Ortigaa/poti-multiplexer/parts.xlsx

Part | Number needed | Explanation | Price (st.) | Number to buy | Notes | url | Final price | Total
Relais shield | 1 | Switching between channels | 14.49 | 1 |  | https://www.conrad.de/de/p/joy-it-kompatibles-board-arduino-mega-2560r3-1409778.html | 7.49
Control for relais | 1 | Arduino or similar for switching control | 13.79 | 1 |  | https://www.conrad.de/de/p/joy-it-kompatibles-board-arduino-mega-2560r3 (https://mail.uni-freiburg.de/SRedirect/F362A017/www.conrad.de/de/p/joy-it-kompatibles-board-arduino-mega-2560r3) | 13.79
Bus cable | 2x10 channels | Connection between relay shield and arduino | 5.99 | 1 |  | https://www.conrad.de/de/p/renkforce-jkmf406-jumper-kabel-arduino-banana-pi-raspberry-pi-40x-drahtbruecken-stecker-40x-drahtbruecken-buchse-60-2299841.html | 5.99
DB9 connector | 8 | Connection to potentiostat trigger signal | 4.58 | 8 |  | https://www.conrad.de/de/p/mh-connectors-mhdm9-db9p-k-d-sub-stiftleisten-set-180-polzahl-9-loetkelch-1-st-1210645.html | 36.64
Multi-channel cable (3>= channels <= 9) | at least 10m | Connection to potentiostat control: from DB9 to Arduino (price per m, 15m) | 1.33 | 15 |  | https://www.conrad.de/de/p/lapp-1026709-1-schleppkettenleitung-oelflex-chain-809-3-g-0-75-mm-grau-meterware-608779.html | 19.95
Mini bannana (2mm) male welded, red | 8 | extend poti electrodes (10/pk) | 0.906 | 1 |  | https://www.mouser.de/ProductDetail/Pomona-Electronics/5936-2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 | 0.906
Mini bannana (2mm) male welded, black | 8 | extend poti electrodes (10/pk) | 0.906 | 1 |  | https://www.mouser.de/ProductDetail/Pomona-Electronics/5936-0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 | 0.906
Mini bannana (2mm) female (socket) welded | 8 | extend poti electrodes (5/pk) | 2.62 | 2 |  | https://www.mouser.de/ProductDetail/Pomona-Electronics/72922-2?qs=2nDnb8a6ouMdaUK3ctZP6A%3D%3D | 5.24
1.5mm cable (red) | 5m | extend poti electrodes (price per m, 5m) | 0.6 | 5 |  | https://www.conrad.de/de/p/lapp-4520041-1-litze-h07v-k-1-x-1-50-mm-rot-meterware-607662.html | 3
1.5mm cable (black) | 5m | extend poti electrodes (price per m, 5m) | 0.6 | 5 |  | https://www.conrad.de/de/p/lapp-4520011-1-litze-h07v-k-1-x-1-50-mm-schwarz-meterware-607619.html | 3
1.5mm cable (blue) | 5m | extend poti electrodes (price per m, 5m) | 0.6 | 5 |  | https://www.conrad.de/de/p/lapp-4520021-1-litze-h07v-k-1-x-1-50-mm-hellblau-meterware-607640.html | 3
PCB boards | 1 | various connections | 2.85 | 4 |  | https://www.conrad.de/de/p/rademacher-wr-typ-811-2-platine-hartpapier-l-x-b-100-mm-x-75-mm-35-m-rastermass-2-54-mm-inhalt-1-st-529580.html | 11.4
Resistors |  | various connections (always good to have) | 9.99 | 1 |  | https://www.conrad.de/de/p/tru-components-418706-kohleschicht-widerstand-sortiment-axial-bedrahtet-5-390-teile-1564789.html | 9.99
Shrinking tube |  | various connections | 8.99 | 1 |  | https://www.conrad.de/de/p/tru-components-tc-6793940-schrumpfschlauchsortiment-schwarz-schrumpfrate-3-1-100-st-1698485.html | 8.99
Header Pin connectors female |  | various connections | 0.966 | 5 |  | https://www.mouser.de/ProductDetail/Samtec/SSW-110-01-T-S?qs=mo%2F4pi%252B%2FVOuo0hu9zJBzaA%3D%3D | 4.83
Computer Fan (120mm) | 2 | Cooling of cells during measurement | 25.3 | 2 | Maybe cheaper in omega | https://www.mouser.de/ProductDetail/Orion-Fans/OD1225-12HBIP69K?qs=zW32dvEIR3vqWiZqa0kqcw%3D%3D | 50.6
cable with inline switch | 2 | Cooling of cells during measurement |  | 2 | Turn on/off fans, but we could just unplug them | Probably in omega | 0
Current adaptor for Fans (if needed) | 2 | Cooling of cells during measurement |  | 2 | Fans likely to work at 5 or 12V, so we need a regulator | Probably in omega | 0
2 channel connectors (female) | 8 | Connect signal cables from poti to duty box | 0.558 | 10 |  | https://www.mouser.de/ProductDetail/TE-Connectivity-AMP/1-480319-9?qs=ko0lFLRalINLBF3JMpSURA%3D%3D | 5.58
2 channel connectors (male) | 8 | Connect signal cables from poti to duty box | 0.469 | 10 |  | https://www.mouser.de/ProductDetail/?qs=ko0lFLRalIM5L%2F%2FJBG4PpQ%3D%3D | 4.69
2 channel connectors pins (female) | 16 | Connect signal cables from poti to duty box | 0.215 | 20 |  | https://www.mouser.de/ProductDetail/?qs=pn%2Fzyis3XjGFb4jHYYY9Mg%3D%3D | 4.3
2 channel connectors pins (male) | 16 | Connect signal cables from poti to duty box | 0.218 | 20 |  | https://www.mouser.de/ProductDetail/?qs=pn%2Fzyis3XjF3U6DRLMBbCg%3D%3D | 4.36
Servo motor for shutter | 8 | Open and close shutter for each cell | 5.84 | 2 |  | https://www.mouser.de/ProductDetail/DFRobot/SER0047 | 11.68
 |  |  |  |  |  |  | 0
 |  |  |  |  |  |  | 0
 |  |  |  |  |  |  | 0
 |  |  |  |  |  |  | 0
 |  |  |  |  |  |  | 0
 |  |  |  |  |  |  | 0
 |  |  |  |  |  |  | 0
 |  |  |  |  |  |  | 0
 |  |  |  |  |  |  | 0
 |  |  |  |  |  |  |  | 216.332
