Ortigaa/poti-multiplexer/holding_box/assembly.FCStd

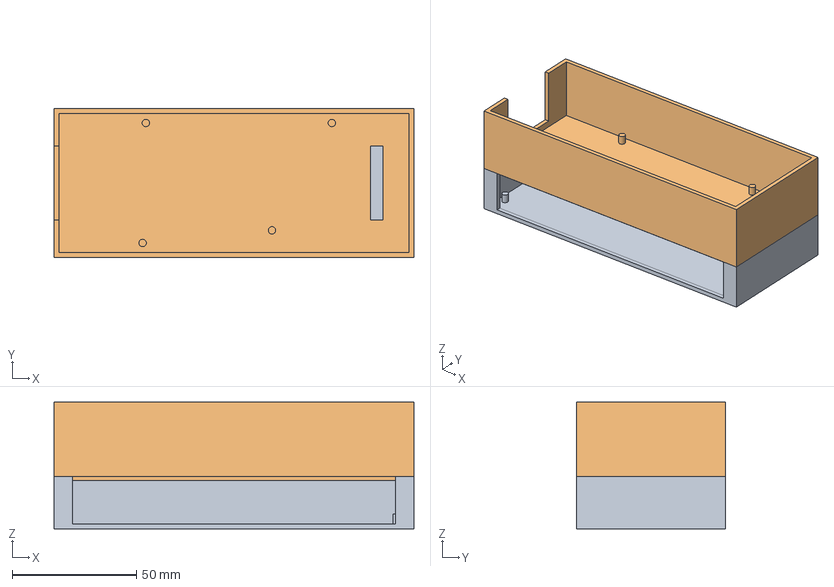
[picture p1: CAD file, 2021-09-03]
holding_box/assembly.FCStd
145.0 x 60.0 x 51.0 mm
bottom_001
middle_001
