Ortigaa/poti-multiplexer/holdig_box_PMMA/assembly.FCStd

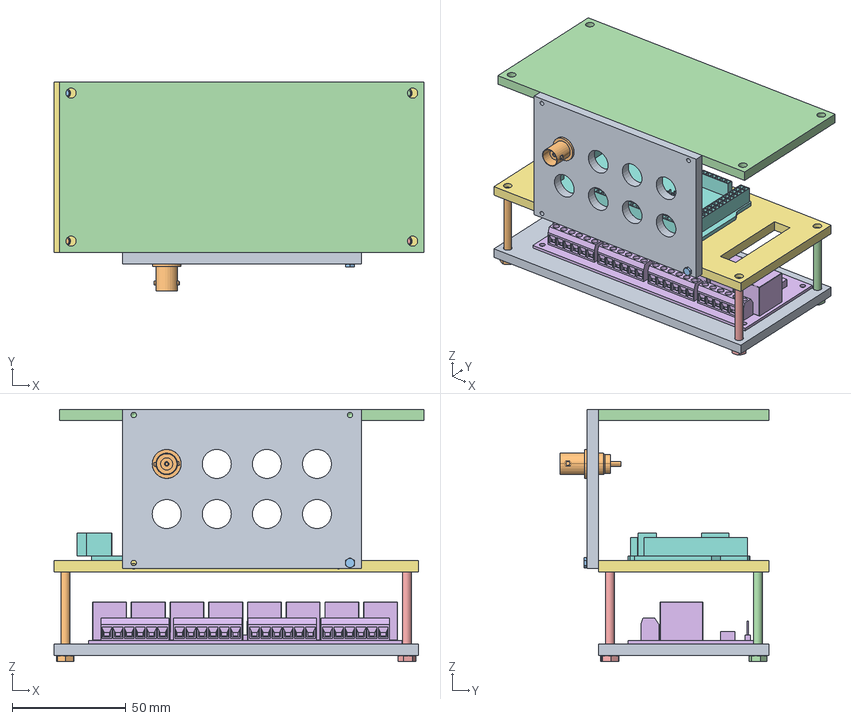
[picture p2: CAD file, 2021-09-03]
holdig_box_PMMA/assembly.FCStd
162.5 x 92.0 x 110.9 mm
bottom_001
M4x40-Screw145
M4x40-Screw
M4x40-Screw146
M4x40-Screw147
8-channel_relay1_001
middle_001
Arduino Mega1_001
BNC_mounting_001
ACX1046-ND_BNC1_001
M2x10-Screw
top_001
