Ortigaa/poti-multiplexer/holdig_box_PMMA/8-channel_relay.STEP

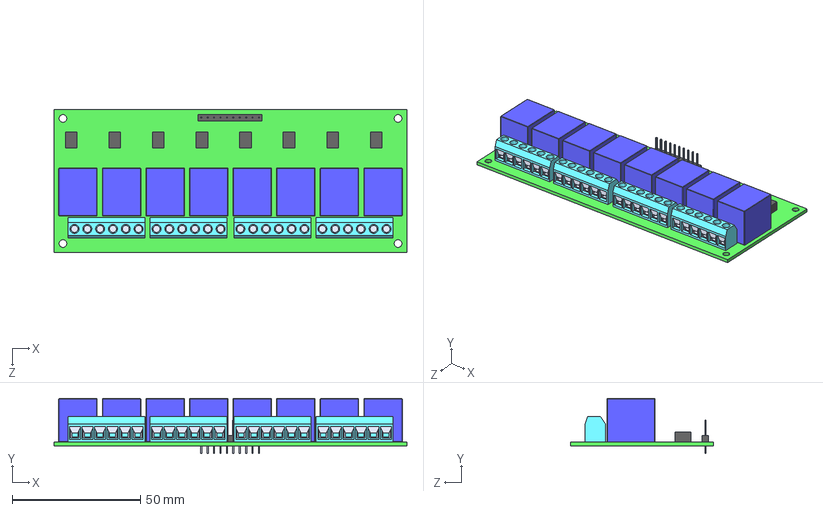
[picture p3: CAD file, 2021-09-03]
holdig_box_PMMA/8-channel_relay.STEP
137.7 x 21.5 x 55.8 mm
