Ortigaa/poti-multiplexer/holding_box/bottom.FCStd

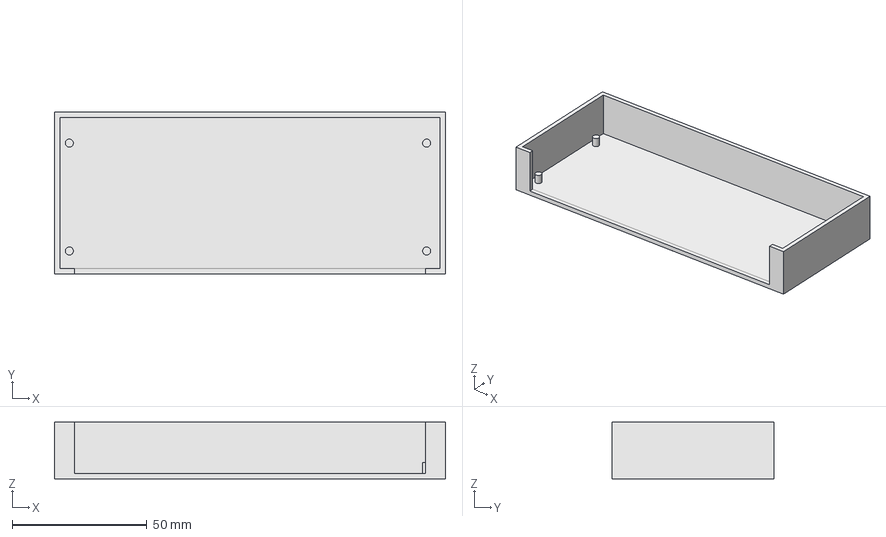
[picture p4: CAD file, 2021-09-03]
holding_box/bottom.FCStd
145.0 x 60.0 x 21.0 mm
