Ortigaa/poti-multiplexer/holdig_box_PMMA/ACX1046-ND_BNC.STEP

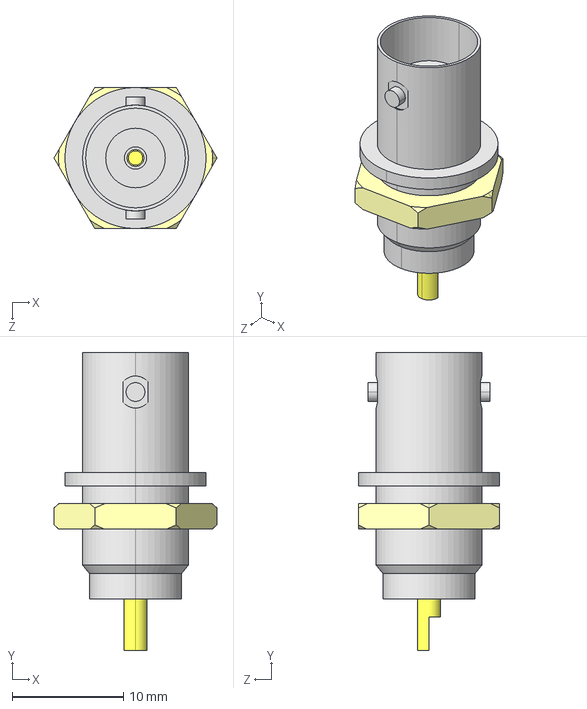
[picture p5: CAD file, 2021-09-03]
holdig_box_PMMA/ACX1046-ND_BNC.STEP
14.7 x 26.8 x 12.7 mm
