Ortigaa/poti-multiplexer/holding_box/middle.FCStd

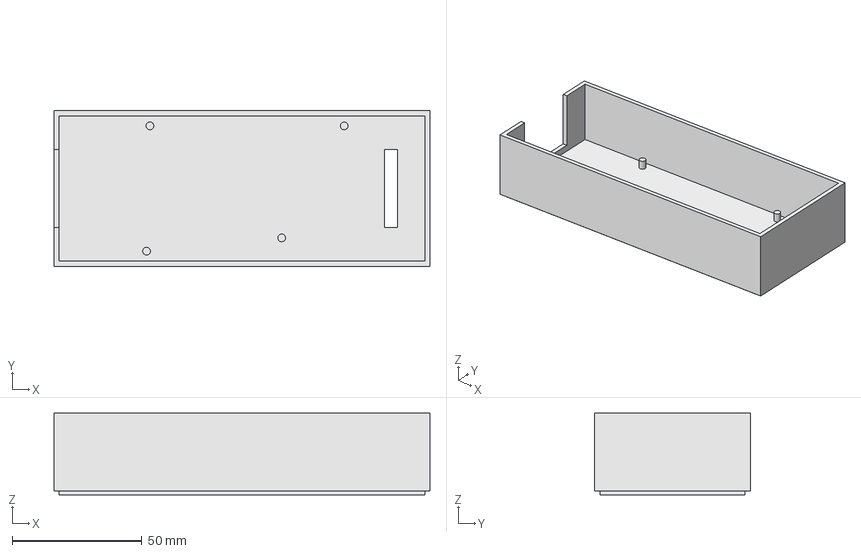
[picture p6: CAD file, 2021-09-03]
holding_box/middle.FCStd
145.0 x 60.0 x 31.5 mm
