Ortigaa/poti-multiplexer/holdig_box_PMMA/middle.FCStd

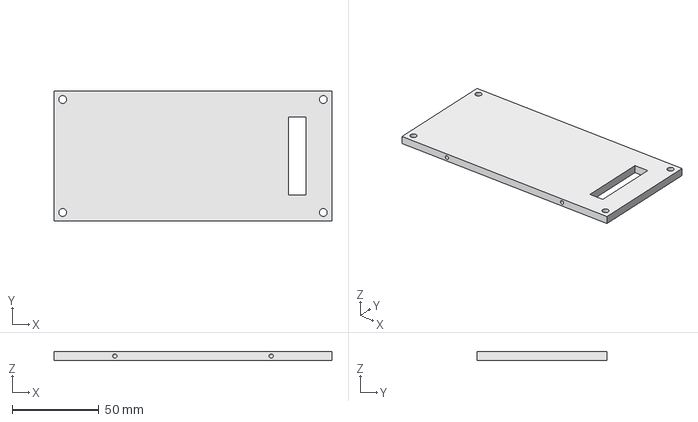
[picture p7: CAD file, 2021-09-03]
holdig_box_PMMA/middle.FCStd
160.0 x 75.0 x 5.00 mm
