Ortigaa/poti-multiplexer/holdig_box_PMMA/Arduino Mega.STEP

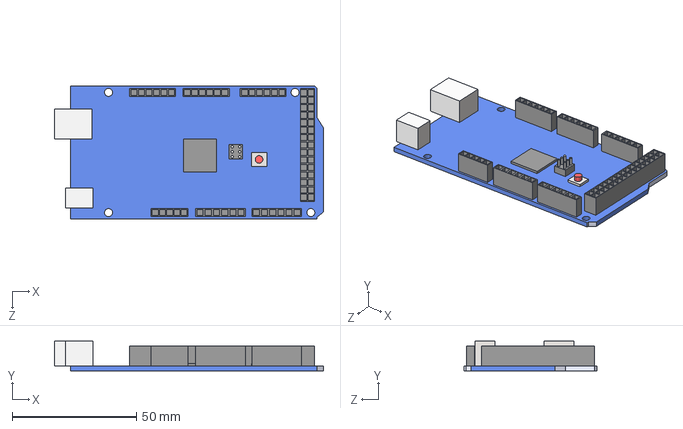
[picture p8: CAD file, 2021-09-03]
holdig_box_PMMA/Arduino Mega.STEP
108.1 x 12.0 x 53.3 mm
