Ortigaa/poti-multiplexer/holdig_box_PMMA/BNC_mounting.FCStd

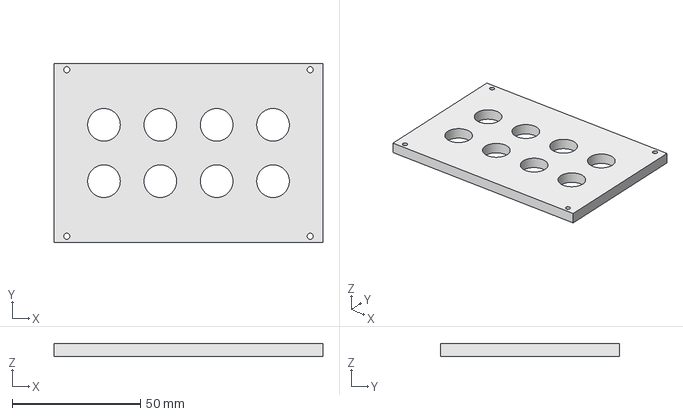
[picture p9: CAD file, 2021-09-03]
holdig_box_PMMA/BNC_mounting.FCStd
105.0 x 70.0 x 5.00 mm
