Ortigaa/poti-multiplexer/(list of files, cad)

Other CAD files:
holdig_box_PMMA/bottom.FCStd
holdig_box_PMMA/top.FCStd
