Ortigaa/poti-multiplexer/holdig_box_PMMA/drawing_assembly.pdf

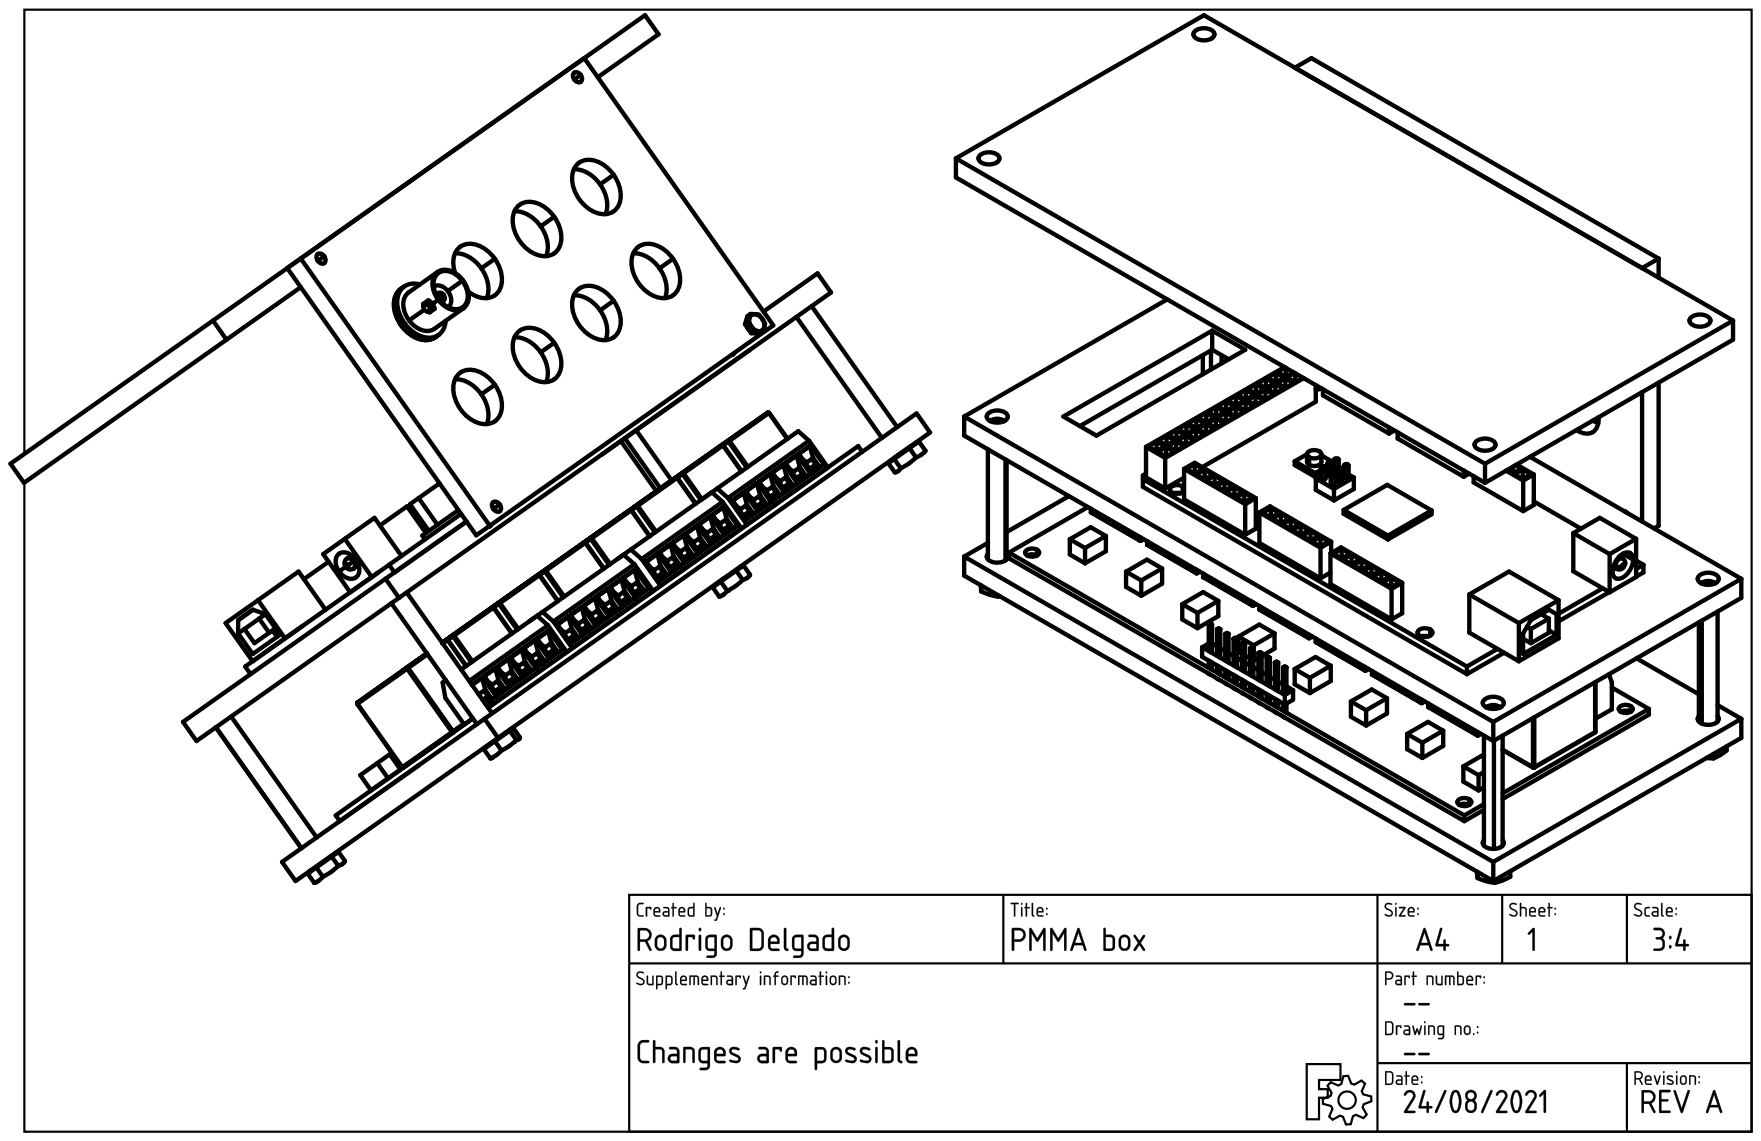
[picture p10: page 1]
