Ortigaa/poti-multiplexer/poti_multiplexer_esquemático.pdf

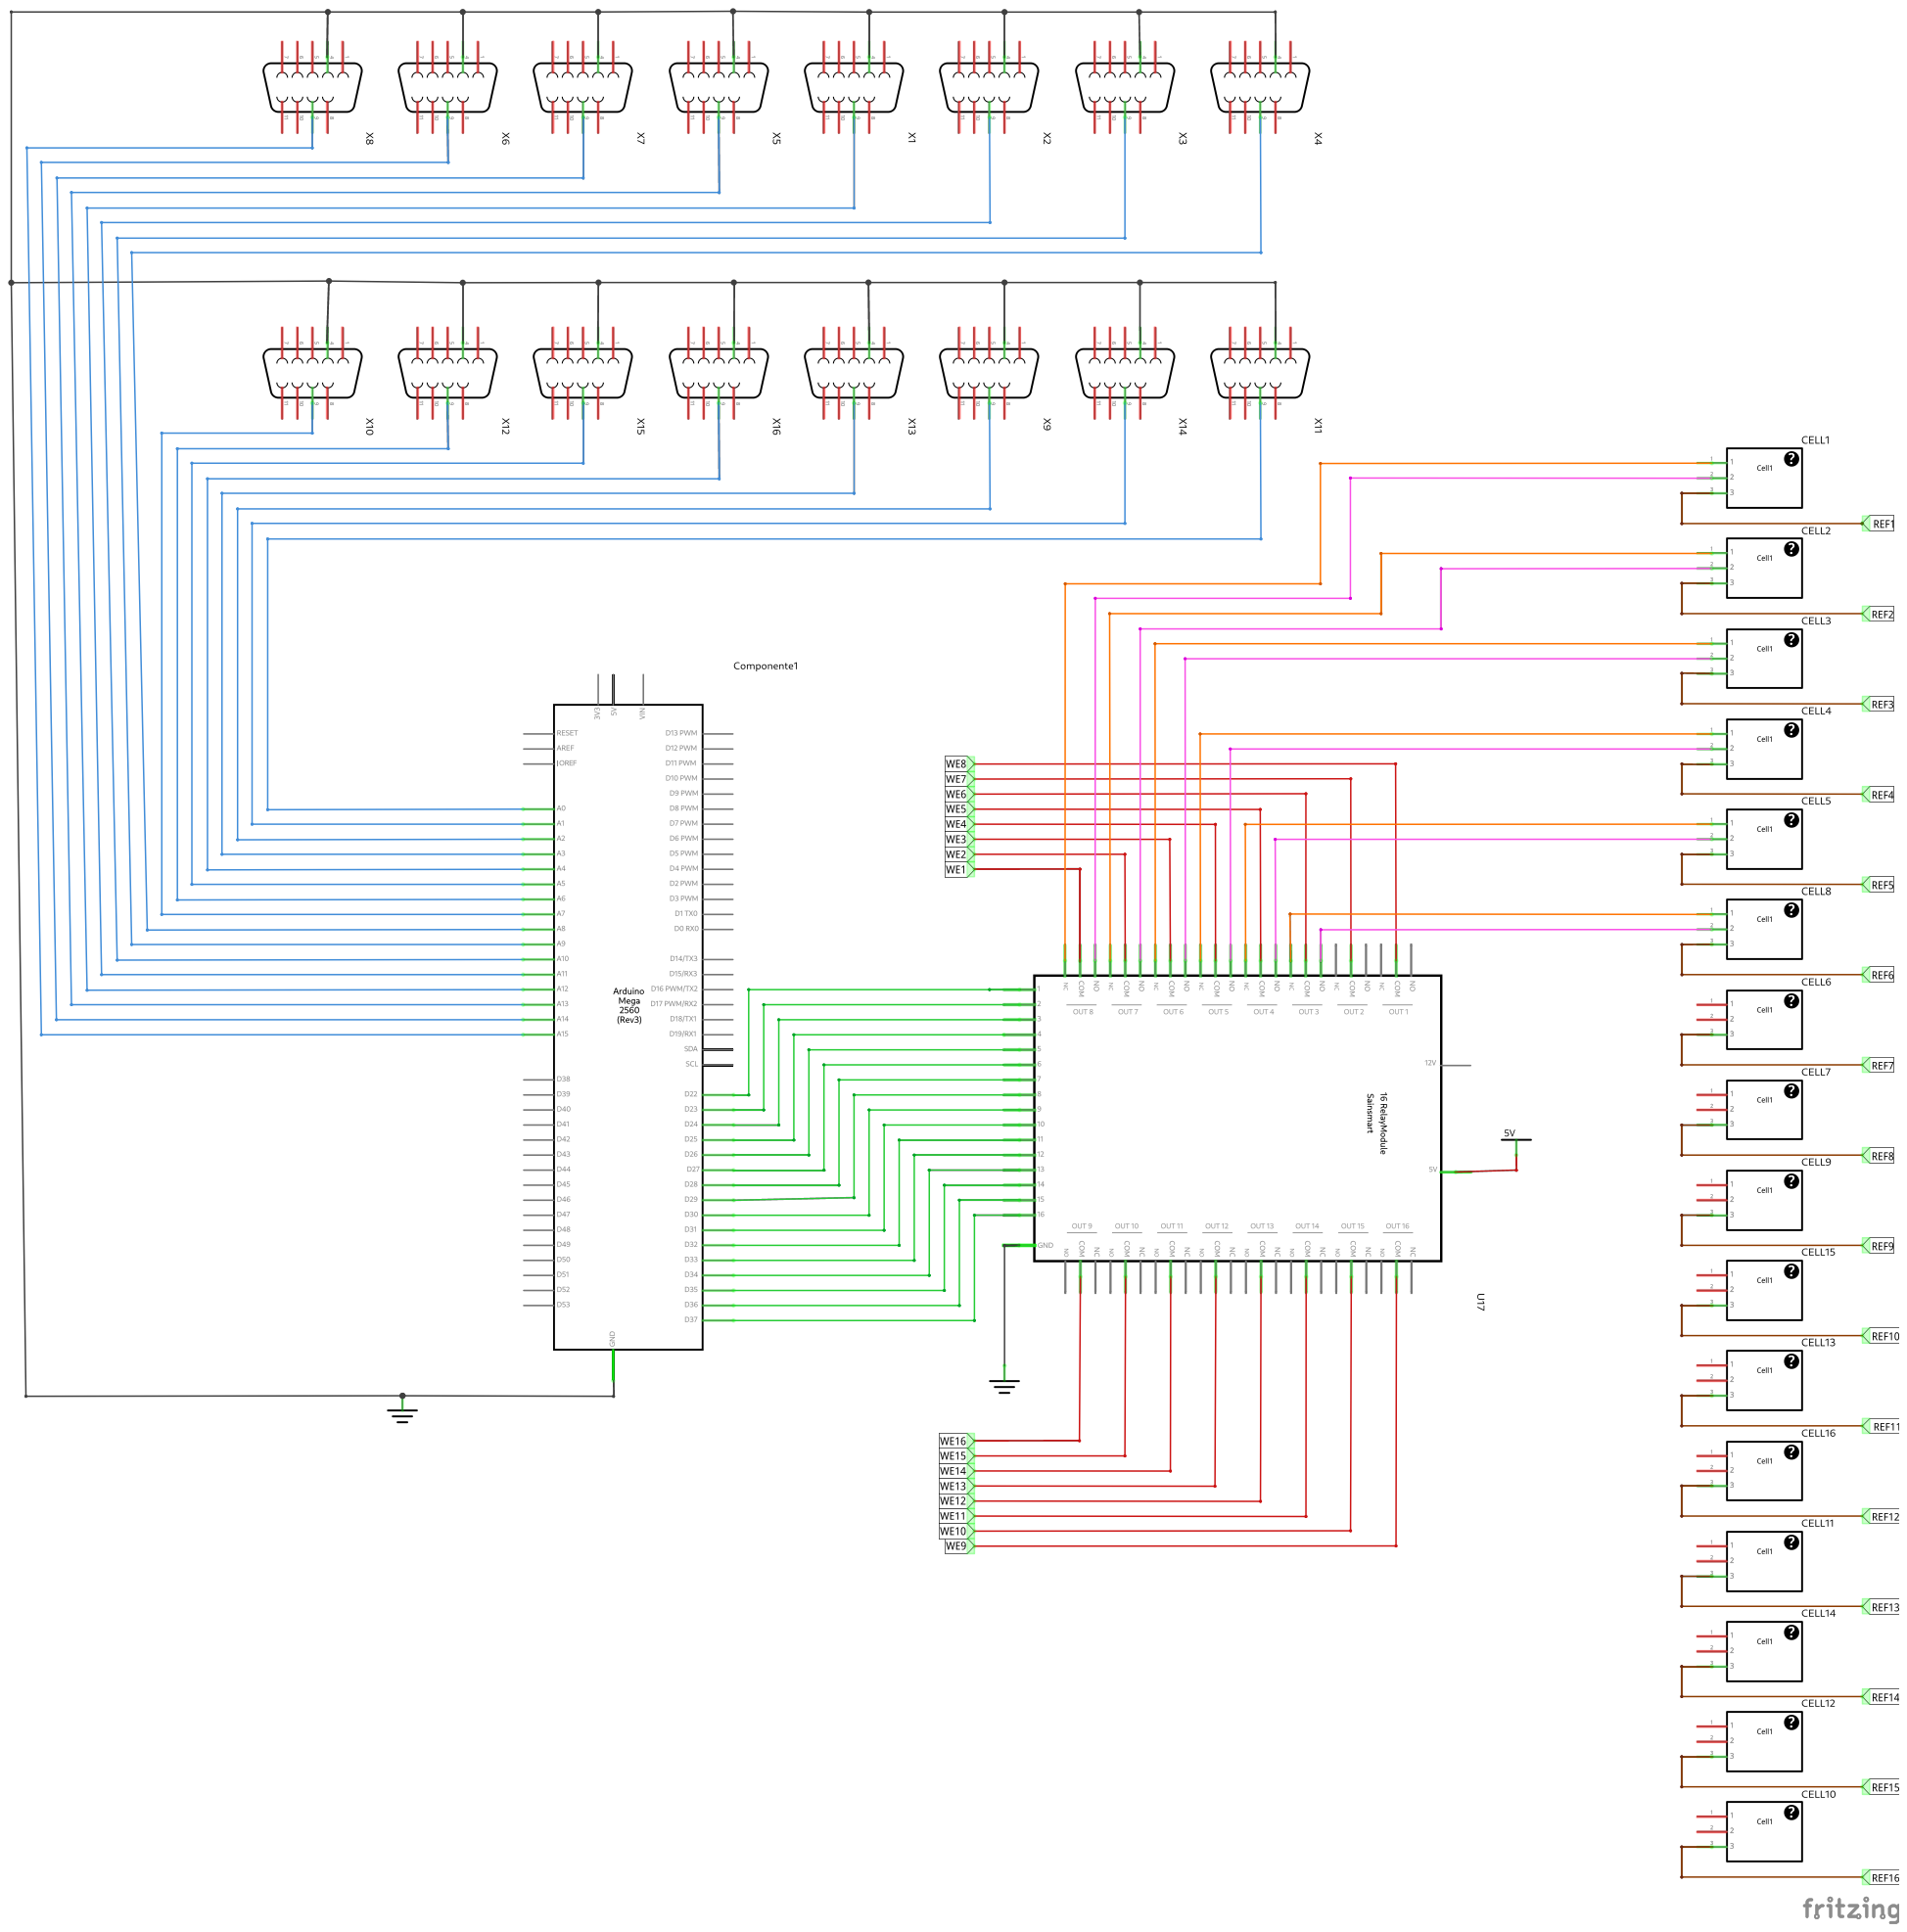
[picture p11: page 1]
