Ortigaa/poti-multiplexer/holdig_box_PMMA/ENG_CD_480319_N1.pdf

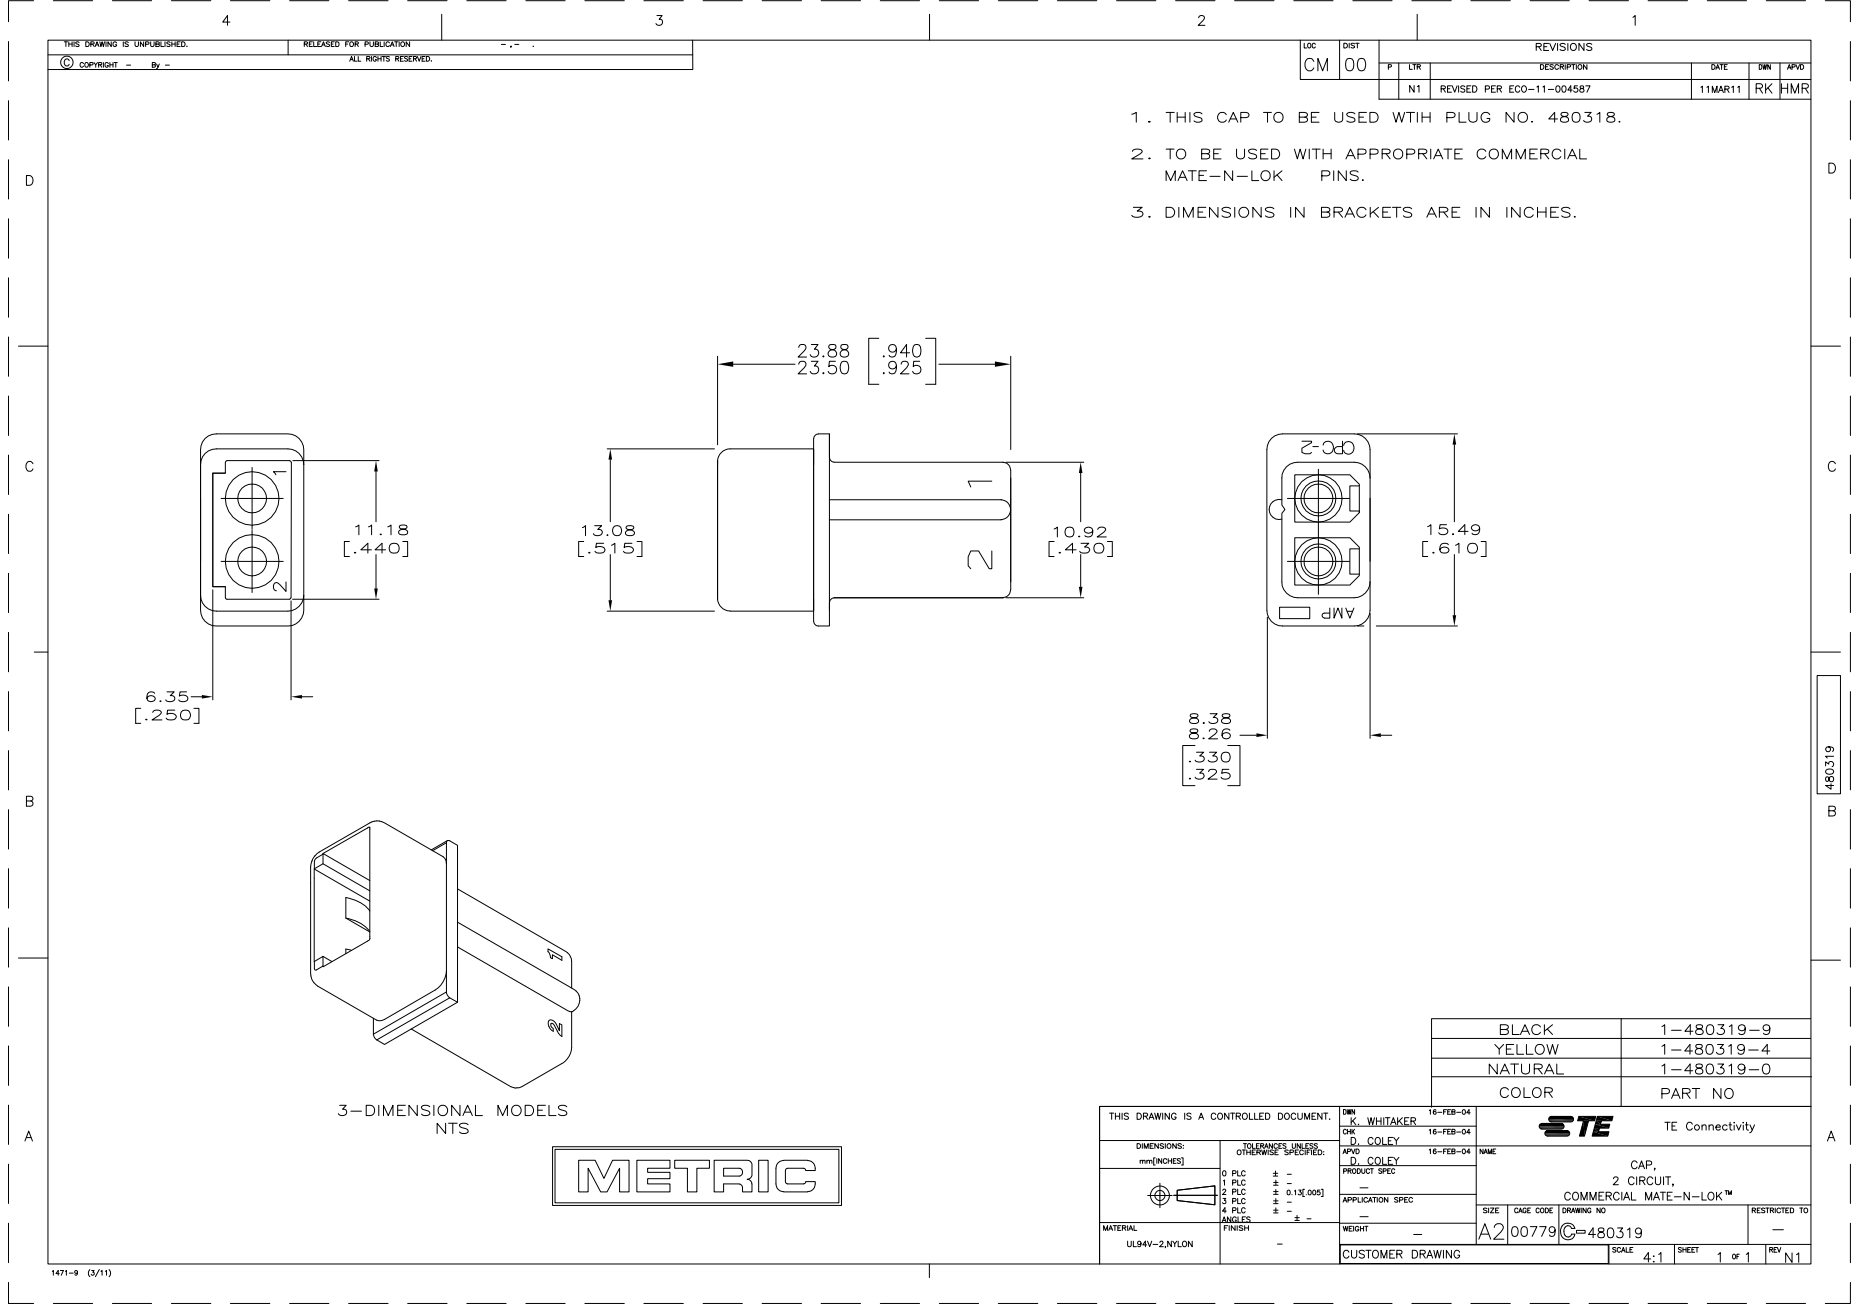
[picture p12: page 1]
